nellbru/crazyflie-charging-deck/Crazyflie_charging_deck_components.xlsx

Component | Type | Quantity per board | Link
STBB1-APUR | Buck Boost | 2 | https://jlcpcb.com/partdetail/STMicroelectronics-STBB1APUR/C967636
DS28E05R+T | 1-Wire chip | 1 | https://jlcpcb.com/partdetail/2156516-DS28E05RT/C2064942
WS2812B-V5/W | RGB LED | 12 | https://jlcpcb.com/partdetail/Worldsemi-WS2812B_V5W/C2874885
HX PM2.0-1x10P TP-YQ | Header | 2 | https://jlcpcb.com/partdetail/hanxia-HX_PM2_0_1x10P_TPYQ/C42379209
C 100 nF 0603 | Capacitor | 12 | https://jlcpcb.com/partdetail/YAGEO-CC0603KRX7R9BB104/C14663
R 15k 0603 | Resistor | 1 | https://jlcpcb.com/partdetail/23536-0603WAF1502T5E/C22809
R 11k 0603 | Resistor | 1 | https://jlcpcb.com/partdetail/26693-0603WAF1102T5E/C25950
R 100k 0603 | Resistor | 2 | https://jlcpcb.com/partdetail/26546-0603WAF1003T5E/C25803
C 10 µF 1206 | Capacitor | 2 | https://jlcpcb.com/partdetail/14236-CL31A106KBHNNNE/C13585
C 22 µF 1206 | Capacitor | 2 | https://jlcpcb.com/partdetail/13537-CL31A226KAHNNNE/C12891
SWPA4020S2R2MT | Inductor | 2 | https://jlcpcb.com/partdetail/Sunlord-SWPA4020S2R2MT/C83423
MB14F | Full bridge rectifier | 1 | https://jlcpcb.com/partdetail/GOODWORK-MB14F/C2943867
 |  | 40
