nellbru/crazyflie-charging-deck/Crazyflie_charging_deck/Crazyflie_charging_deck.kicad_pcb

## KiCad design Crazyflie_charging_deck/Crazyflie_charging_deck.kicad_pcb (2026-09-28)

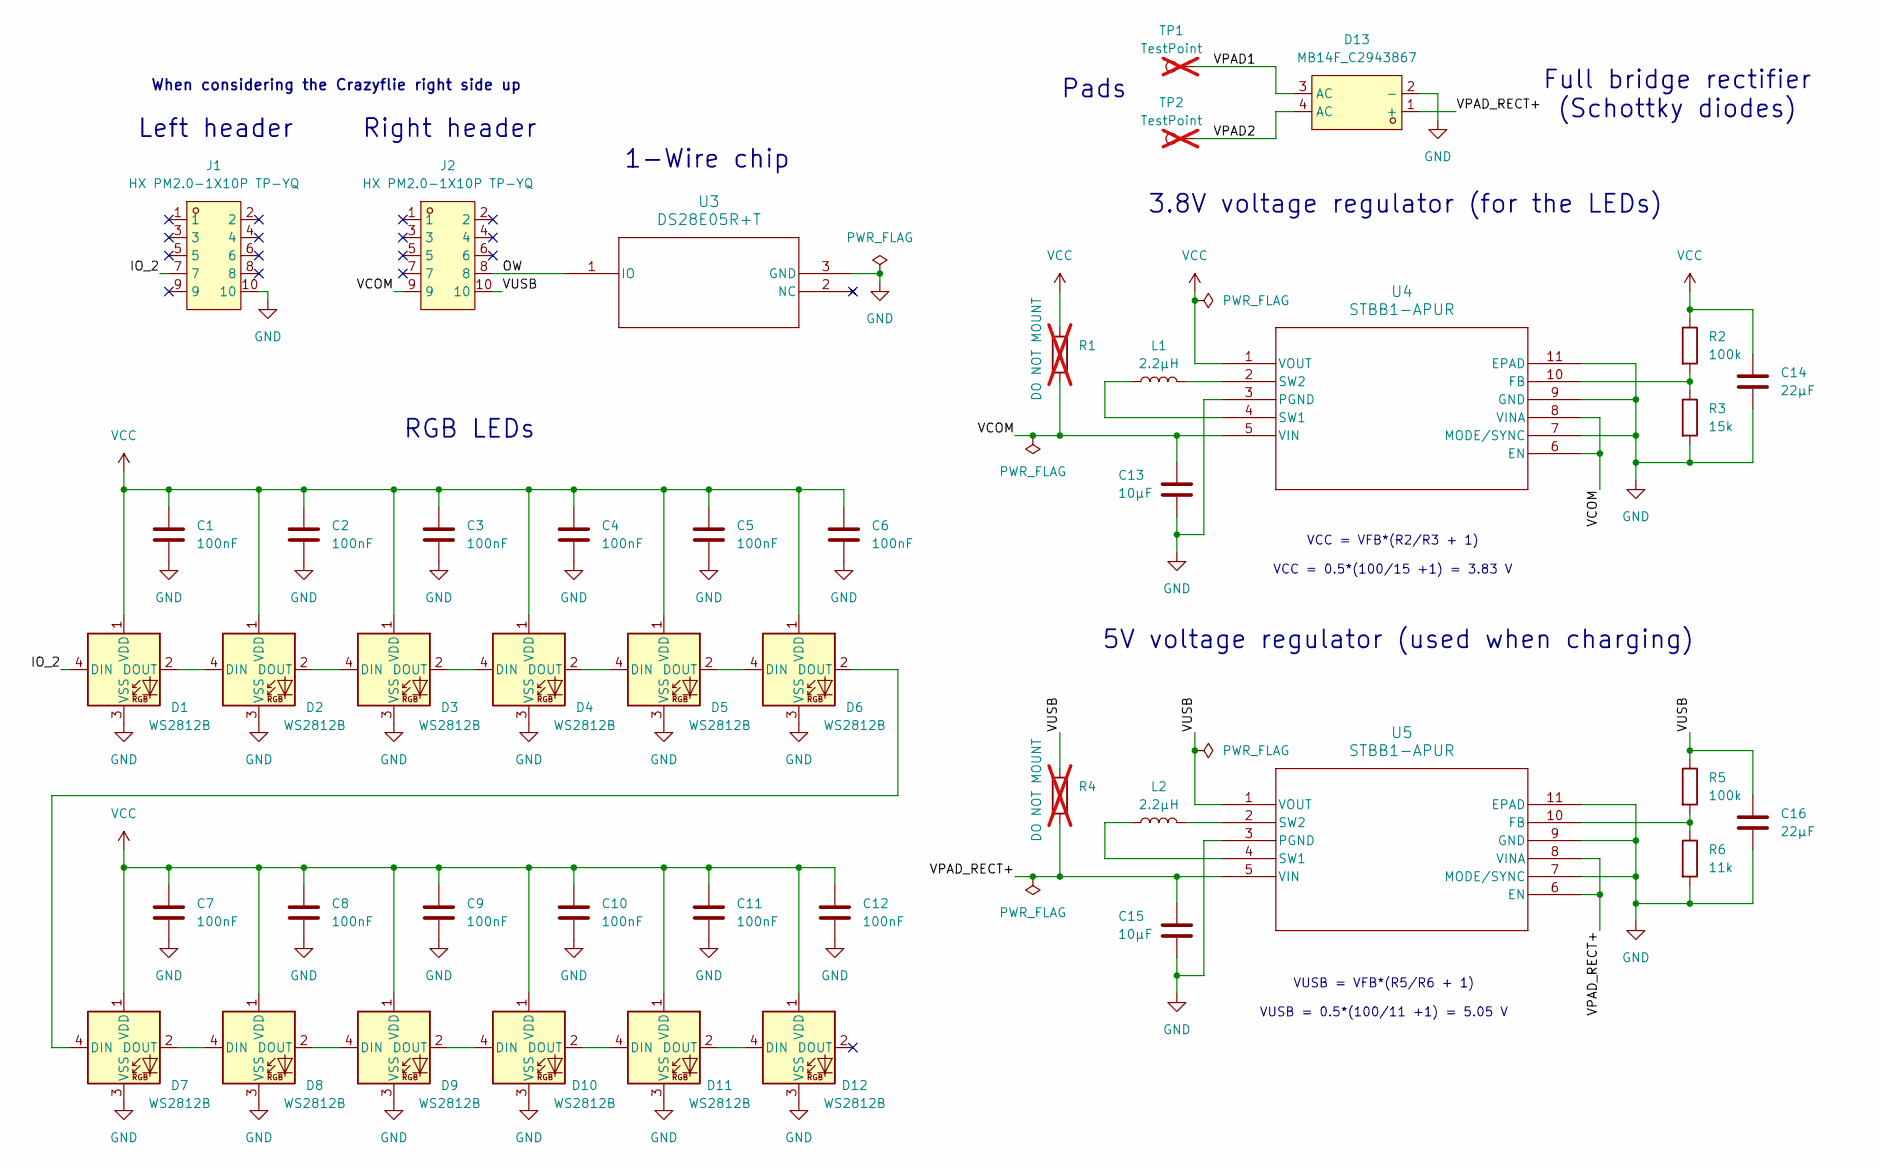
[picture p1: schematic Crazyflie_charging_deck.kicad_sch, Crazyflie charging deck]

Parts:
C1, C2, C3, C4, C5, C6, C7, C8, C9, C10, C11, C12: 100nF; C_0603_1608Metric; LCSC Part C14663
C13, C15: 10µF; C_1206_3216Metric; LCSC Part C13585
C14, C16: 22µF; C_1206_3216Metric; LCSC Part C12891
D1, D2, D3, D4, D5, D6, D7, D8, D9, D10, D11, D12: WS2812B; LED_WS2812B_PLCC4_5.0x5.0mm_P3.2mm; LCSC Part C2874885
D13: MB14F_C2943867; MBF-SMD_L4.7-W3.8-P2.50-LS7.0-BL; MPN MB14F; LCSC Part C2943867
J1, J2: HX PM2.0-1X10P TP-YQ; CONN-SMD_10P-P2.00_TPYE-1_SMD-10P; MPN HX PM2.0-1x10P TP-YQ; LCSC Part C42379209
L1, L2: 2.2µH; L_Sunlord_SWPA4020S; LCSC Part C83423
R1, R4: DO NOT MOUNT; R_0603_1608Metric; not fitted
R2, R5: 100k; R_0603_1608Metric; LCSC Part C25803
R3: 15k; R_0603_1608Metric; LCSC Part C22809
R6: 11k; R_0603_1608Metric; LCSC Part C25950
TP1, TP2: TestPoint; TestPoint_Pad_4.0x4.0mm; not fitted
U3: DS28E05R+T; LCSC Part C2064942
U4, U5: STBB1-APUR; LCSC Part C967636

Connections:
/IO_2: D1.4 (DIN), J1.7
/OW: J2.8, U3.1 (IO)
/VCOM: C13.1, J2.9, R1.2, U4.5 (VIN), U4.6 (EN), U4.8 (VINA)
/VPAD1: D13.3 (AC), TP1.1 (1_1)
/VPAD2: D13.4 (AC), TP2.1 (1_1)
/VPAD_RECT+: C15.1, D13.1 (+), R4.2, U5.5 (VIN), U5.6 (EN), U5.8 (VINA)
/VUSB: C16.1, J2.10, R4.1, R5.1, U5.1 (VOUT)
GND: C1.2, C2.2, C3.2, C4.2, C5.2, C6.2, C7.2, C8.2, C9.2, C10.2, C11.2, C12.2, C13.2, C14.2, C15.2, C16.2, D1.3 (VSS), D2.3 (VSS), D3.3 (VSS), D4.3 (VSS), D5.3 (VSS), D6.3 (VSS), D7.3 (VSS), D8.3 (VSS), D9.3 (VSS), D10.3 (VSS), D11.3 (VSS), D12.3 (VSS), D13.2 (-), J1.10, R3.2, R6.2, U3.3 (GND), U4.3 (PGND), U4.7 (MODE/SYNC), U4.9 (GND), U4.11 (EPAD), U5.3 (PGND), U5.7 (MODE/SYNC), U5.9 (GND), U5.11 (EPAD)
unnamed: D1.2 (DOUT), D2.4 (DIN)
unnamed: D2.2 (DOUT), D3.4 (DIN)
unnamed: D3.2 (DOUT), D4.4 (DIN)
unnamed: D4.2 (DOUT), D5.4 (DIN)
unnamed: D5.2 (DOUT), D6.4 (DIN)
unnamed: D6.2 (DOUT), D7.4 (DIN)
unnamed: D7.2 (DOUT), D8.4 (DIN)
unnamed: D8.2 (DOUT), D9.4 (DIN)
unnamed: D9.2 (DOUT), D10.4 (DIN)
unnamed: D10.2 (DOUT), D11.4 (DIN)
unnamed: D11.2 (DOUT), D12.4 (DIN)
unnamed: R2.2, R3.1, U4.10 (FB)
unnamed: L1.1, U4.4 (SW1)
unnamed: L1.2, U4.2 (SW2)
unnamed: R5.2, R6.1, U5.10 (FB)
unnamed: L2.1, U5.4 (SW1)
unnamed: L2.2, U5.2 (SW2)
VCC: C1.1, C2.1, C3.1, C4.1, C5.1, C6.1, C7.1, C8.1, C9.1, C10.1, C11.1, C12.1, C14.1, D1.1 (VDD), D2.1 (VDD), D3.1 (VDD), D4.1 (VDD), D5.1 (VDD), D6.1 (VDD), D7.1 (VDD), D8.1 (VDD), D9.1 (VDD), D10.1 (VDD), D11.1 (VDD), D12.1 (VDD), R1.1, R2.1, U4.1 (VOUT)

Notes on the sheet:
VCC = VFB*(R2/R3 + 1) VCC = 0.5*(100/15 +1) = 3.83 V
VUSB = VFB*(R5/R6 + 1) VUSB = 0.5*(100/11 +1) = 5.05 V
5V voltage regulator (used when charging)
When considering the Crazyflie right side up
RGB LEDs
Right header
Left header
Pads
Full bridge rectifier (Schottky diodes)
1-Wire chip
3.8V voltage regulator (for the LEDs)

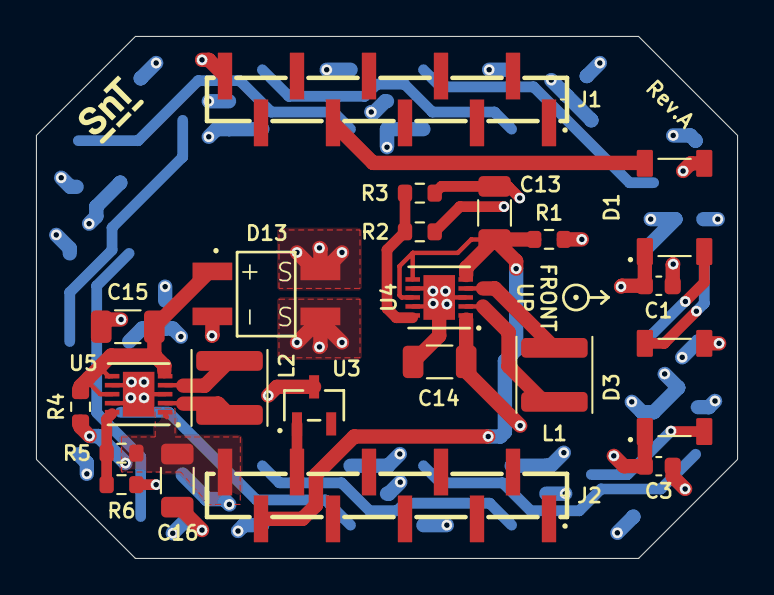
[picture p2: board Crazyflie_charging_deck.kicad_pcb from above]

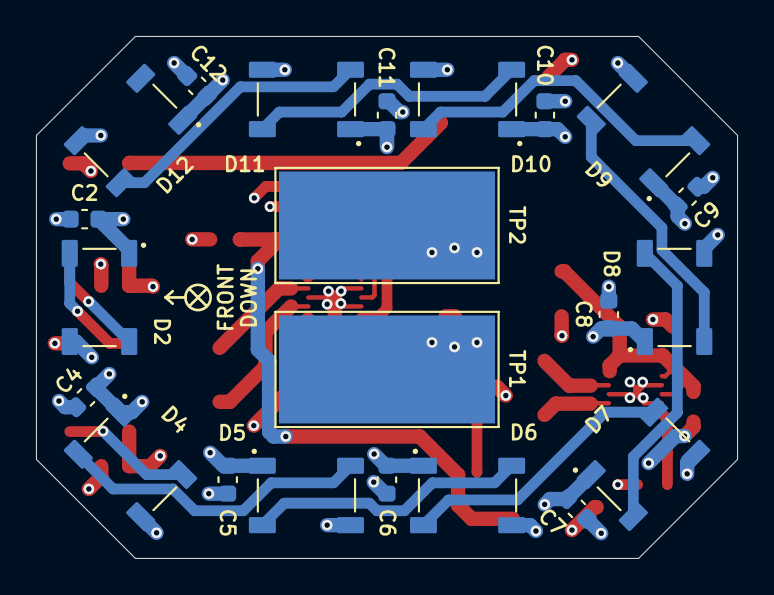
[picture p3: board Crazyflie_charging_deck.kicad_pcb from below]

Board: 4 copper layers, 38.9 x 29.0 mm, 45 parts (22 on the bottom side), 26 nets.

Other parts of the board:
EXP_ORIENTATION: VAL**; CF_orientation
