nellbru/crazyflie-charging-deck/(commit log)

2026-08-19 Create KiCad project
    [Crazyflie_charging_deck.kicad_pcb, Crazyflie_charging_deck.kicad_sch]
2026-08-21 Add list of components
    [Crazyflie_charging_deck_components.xlsx]
2026-08-21 Add flash_ow.py to flash the 1-Wire chip
2026-08-21 Update KiCad project
    [Crazyflie_charging_deck.kicad_sch, Crazyflie_charging_deck_components.xlsx]
2026-09-28 Update components list
    [Crazyflie_charging_deck_components.xlsx]
2026-09-28 Import footprints library
2026-09-28 Complete Rev.A layout
    [Crazyflie_charging_deck.kicad_pcb, Crazyflie_charging_deck.kicad_sch]
2026-09-28 Import production files
    [bom.csv, designators.csv, positions.csv]
